MostlyCoraGrace/BardBarian/Electronics/MouseSwitchTest/MouseSwitchTest.kicad_pcb

## KiCad design Electronics/MouseSwitchTest/MouseSwitchTest.kicad_pcb (2024-04-26)

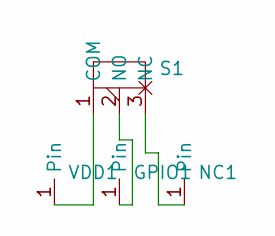
[picture p1: schematic MouseSwitchTest.kicad_sch]

Parts:
GPIO1: Header
NC1: Header
S1: Kailh GM 4.0 Red CMI126601D01
VDD1: Header

Connections:
unnamed: GPIO1.1, S1.2 (NO)
unnamed: NC1.1, S1.3 (NC)
unnamed: S1.1 (COM), VDD1.1

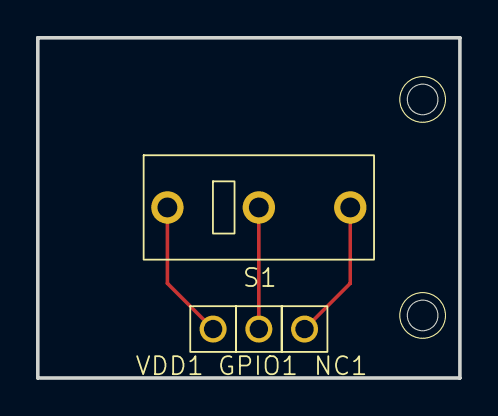
[picture p2: board MouseSwitchTest.kicad_pcb from above]

Board: 2 copper layers, 23.5 x 18.9 mm, 4 parts (0 on the bottom side), 3 nets.
