MostlyCoraGrace/BardBarian/(commit log)

2024-03-30 init kicad files
    [SrollWheel_Encoder.kicad_pcb, SrollWheel_Encoder.kicad_sch]
2024-03-31 started the scroll wheel pcb
    [SrollWheel_Encoder.kicad_pcb]
2024-04-03 started work on the springs
    [MouseSwitchTest.kicad_pcb, MouseSwitchTest.kicad_sch]
2024-04-04 fixed the return stop of the scroll middle click hinge intersecting with the test jig
2024-04-04 moved the footprint library to its own root folder
2024-04-05 added kailh gm4 mouse switch footprint and symbol
2024-04-05 added the mouse switch test pcb
    [MouseSwitchTest.kicad_pcb, MouseSwitchTest.kicad_sch]
2024-04-05 initialised the 3d print files
    [Printed - Bearing Holder.stl, Printed - Bearing Mount.stl, Printed - Sensor Mount.stl, Printed - Shroud_Large.stl]
2024-04-20 beveled the sensor holder
2024-04-21 updated the middle click pcb
    [MouseSwitchTest.kicad_pcb]
2024-04-21 removed the old encoder pcb
    [SrollWheel_Encoder.kicad_pcb, SrollWheel_Encoder.kicad_sch]
2024-04-21 removed old printable files
    [Printed - Bearing Holder.stl, Printed - Bearing Mount.stl, Printed - Sensor Mount.stl, Printed - Shroud_Large.stl, Printed_BasePlate.stl]
2024-04-26 rotated the middle click mouse switch to avoid collisions with the assistive springs
    [MouseSwitchTest.kicad_pcb]
